HARSH070105/tml_work/Intern Report - Harsh Kapoor.pdf

Internship Project Report

## Automated A.C. Vent Controlling System

Submitted by

Harsh Kapoor
Electronics and Communication Engineering International Institute of Information Technology - Hyderabad

Under the guidance of

Kartar Singh
Deputy General Manager
Tata Motors, Engineering Research Centre

Varnit Vats
General Manager
Tata Motors, Engineering Research Centre

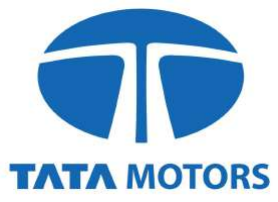
[picture p1: figure]

## TATA MOTORS

Engineering Research Centre

Summer Internship 2025

# Contents

1 Objective | 1
2 Introduction | 2
3 Work Done | 10
4 Future Work | 28
Acknowledgment | 29
References | 30

i

# Chapter 1

# Objective

The primary objective of this project was to automate the operation of air-conditioning (A.C.) vents in electric commercial vehicles, thereby enhancing energy efficiency and passenger comfort. The task involved designing a smart control system that could dynamically manage the A.C. vents based on passenger presence. To achieve this, the following goals were set:

- Passenger Detection Pipeline: Develop a reliable pipeline to detect and localize passengers in the vehicle cabin using appropriate sensing and vision-based techniques.
- Vent Control Mechanism: Design and implement a mechanism capable of actuating A.C. vents—opening or closing them—based on control commands.
- System Integration: Seamlessly integrate the passenger detection system with the A.C. vent control mechanism to allow real-time, responsive operation.
- Proof of Concept (PoC): Build a functional proof of concept simulating various components of an electric commercial vehicle to demonstrate the end-to-end working of the proposed solution.

# Chapter 2

# Introduction

## 2.1 Vehicle Studies

As part of the internship, I was tasked to study the various electronic sensors and control units used in commercial vehicles. This involved gaining a detailed understanding of the components that contribute to vehicle automation, safety, and control. The Vehicles I studied are -

### 2.1.1 CNG - 1620 Buro - 6

This was a CNG vehicle equipped with six CNG tanks. The vehicle had dimensions of a × b where a is the floor height in 100s of mm and b is the bus length from front to back.
The following image is a diagrammatic representation of the vehicle layout. It indicates the placement of the various sensors and electronic controllers throughout the vehicle.

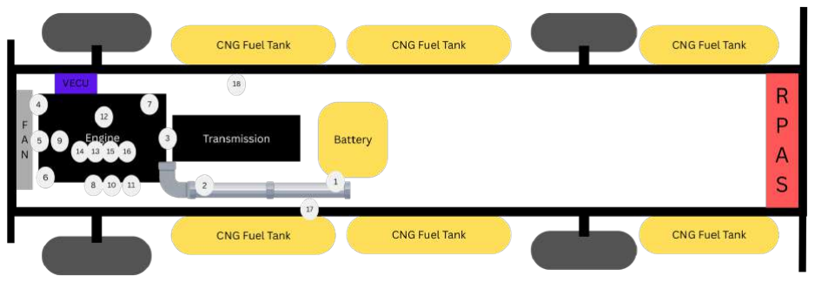
[picture p2: figure]

Figure 2.1: Diagrammatic Representation of 1620 CNG Vehicle

The Description of the components (along with the names of the numbered components in the image) are as follows -

S.No | Sensor Name | Sensor Purpose
1 | G.P.F. | GPF (Gasoline Particulate Filter) sensor is a compo-nent of the exhaust system in gasoline engines designed to capture particulate matter. It works by measuring pressure differences across the GPF, which indicates the amount of soot buildup within the filter. This informa-tion is then used by the engine control unit (ECU) to trigger regeneration cycles, which burn off the trapped soot and maintain optimal filter performance
2 | Post Oxygen Sensor | Detects the concentration of oxygen molecules in the ex-haust air, this combined with the Pre Oxygen measure-ment tells the ECU the amount of Oxygen being used in engine for fuel combustion, and whether it needs more air to be sucked in or not.
3 | Crank Sensor | Monitors the position or rotational speed of the crankshaft (converts linear motion of pistons to rota-tional motion of wheels)
4 | E Viscous Fan | Utilizes electronic control to optimize fan speed and op-eration for cooling engine. It is controlled by the ECU, and this is based on Engine oil temperature and the coolant temperature. Its speed can be varied instead of being in a binary state (on/off based on bimetallic strip).
5 | CAM | Monitors the camshaft (which controls the timing of in-let and exhaust valve operations) position and speed and feeds that data to the vehicle’s ECU. The ECU needs this data to control how much fuel enters the combus-tion chamber and ignition (spark) timing to ignite the fuel.
6 | ETB | (Electric Throttle Body) Controls how much air the ve-hicle’s engine receives based on how far the gas pedal is pressed. Controlled by the ECU based on the gas pedal, and the oxygen sensors data.
7 | Oil Pressure and Tem-perature Sensor | Measures the pressure and temperature of the engine oil. This data is fed to the ECU and controls the Fans speed and the amount of coolant intake.
8 | Pre Oxygen Sensor | Detects the concentration of oxygen molecules in the intake air and the data is passed on the ECU for the usage in ETB control.
9 | Coolant Temperature Sensor | To sense the temperature of the coolant of the engine.
10 | Pre Throttle TMAP Sensor | Measures the temperature and pressure of the air before it enters the throttle body (controls air intake) of an engine. Throttle is the valve from which air enters the engine; therefore, the sensor measures the temperature and pressure of the air entering the engine so that the control of intake air can be done.

11 | Exhaust Temperature Sensor | To sense the temperature of the exhaust gas of the en-gine. This helps in optimizing engine performance by changing fuel oxygen fix in engine.
12 | Ignition Coils | Transform the low voltage from the battery (here 24V) into a much higher voltage (tens of thousands of volts) needed to create a spark at the spark plug, igniting the fuel-air mixture in the engine.
13 | Fuel Injectors | Device for atomizing and injecting fuel into an internal combustion engine
14 | TMAP Sensor | Measures the pressure and temperature of the air in an engine. This helps in the efficiency of engine by control-ling the combustion by fuel and air by ecu.
15 | Fuel Rail Tempera-ture Sensor | Monitors the temperature inside the fuel rail (a metal tube that connects the fuel delivery system to the en-gine)
16 | Gas Rail Pressure Sensor | Monitors the pressure inside the gas (CNG) rail (a metal tube that connects the fuel delivery system to the en-gine)
17 | VECU | Manages and controls various electronic systems using the data from the sensors of the vehicle.
18 | HP Cutoff Solenoid Assembly | Used to shut off the flow of High-pressure Fuel at the fuel inlet.
19 | RPAS Sensor | Reverse Parking Assistance Systems are automated parking systems that help drivers park with extreme ease and precision.
20 | NOX Sensor | Measures the amount of Nitrogen Oxides in the exhaust fumes.

### 2.1.2 Electric Vehicle - Magna

This was an electric vehicle equipped with four 700kg, 665.6V, 150Ah, 99.84kWh battery packs which are connected in parallel.
The following image is a diagrammatic representation of the vehicle layout. It indicates the placement of the various sensors and electronic controllers throughout the vehicle.

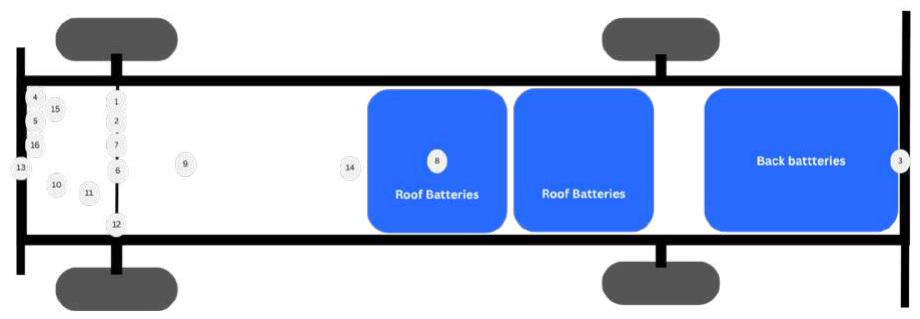
[picture p3: figure]

Figure 2.2: Diagrammatic Representation of Magna Vehicle

The Description of the components (along with the names of the numbered components in the image) are as follows -

S.No. | Sensor Name | Sensor Purpose
1 | G.D.C.U. | Gateway Domain Control Unit, acts as a hub for data exchange, and connects various parts of the vehicle via signals
2 | VECU | Vehicle Electronic Control Unit, used for low voltage controls
3 | RPAS | Assists the driver in reversing and parking by using range detection to scan the surroundings. 5 in number – 1 master and 4 slave sensors, all at the back
4 | Data Logger | Logs the data of various sensors with time stamps for troubleshooting and sequencing of commands
5 | TCU Telematics | Provides telematics data (GPS, IMU, etc.) of the vehicle
6 | E.B.S. | Electronic Braking System; helps achieve shorter brak-ing distances using electronic control signals
7 | EVCU | Electric Vehicle Control Unit, used in high voltage con-trols
8 | BMS | Battery Monitoring System; manages the health and status of the battery pack
9 | MCU | Motor Control Unit; controls speed and gear ratio of the motors
10 | DC-DC Converter | Converts DC high voltage to DC low voltage, or vice versa
11 | AUX | Converts DC to AC for powering systems like power steering (AUX 1) and the AC unit (AUX 2)
12 | TCP | Traction Cooling Pump; used to control motor traction temperature
13 | HVAC | AC Control Unit; controls the blower and compressor settings
14 | BCS | Battery Control System; controls the charge/discharge rate of the battery, optimizing performance
15 | Steering Angle | Detects the angle to which the steering wheel is turned
16 | DMS | Driver Monitoring System; monitors the driver’s state and helps keep them alert

## 2.2 A.C. Vent Fitment

I also visited the Tata Motors Body Solutions Limited (TMBSL) plant to inspect the A.C. vent fitment in the vehicle. The objective of the visit was to understand the feasibility of designing a mechanism that could automate the opening and closing of the A.C. vents using actuators. Images of the vents in their open and closed positions are shown below:

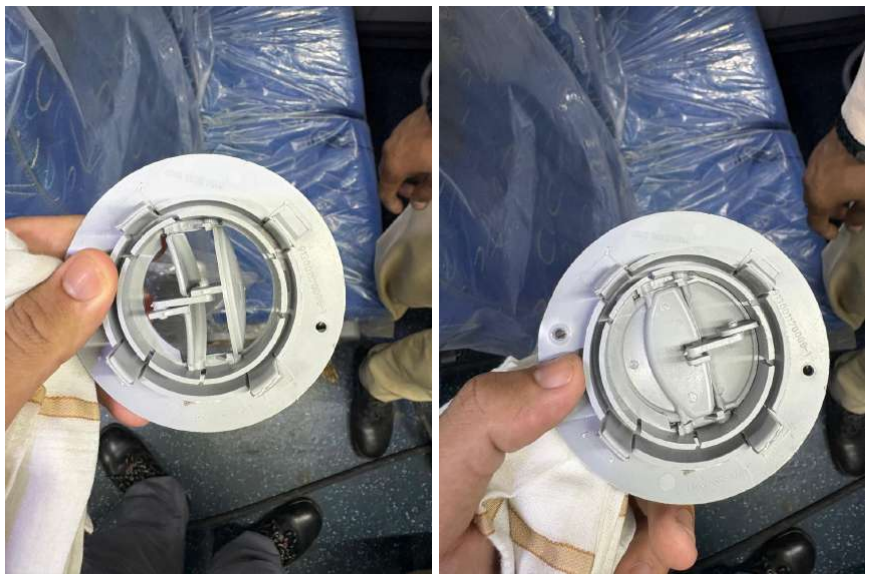
[picture p4: figure]

Figure 2.3: Vent in Open and Closed Position

I also Calculated the area and the number of AC Vents as a part of the project so that the Compressor and Blower in the vehicle can be adjusted based on the number of closed/open vents so that energy can be saved. The Detailed Calculations are given in the following sections.

## 2.3 Passenger Detection Techniques

To enable automatic opening and closing of the A.C. vents based on passenger presence, I proposed the following methods of passenger detection, with their respective advantages and limitations-

### 2.3.1 Pressure Sensor

The idea is to have pressure sensors in seat to detect the weight of a person on the seats. It is similar to the seatbelt warnings in passenger vehicles. A certain threshold of weight will be required for the vents to respond to.

Advantages:

- The main advantage is that it is very easy to interface, as one sensor controls one vent.
- It is already used in Passenger Vehicles so the complexity of ideation is excluded.

Disadvantages:

- Will be needing at-least one per seat, the wiring will increase.
- This method not be able to distinguish between Humans and other objects kept on seat.

### 2.3.2 Infra-Red/Temperature Sensor

The idea is to have I.R. Sensors pointing at seats to detect human body temperatures. This method will turn on the AC Vents if the human body temperature is detected and will turn it off if it is not detected for a prolonged period of time.

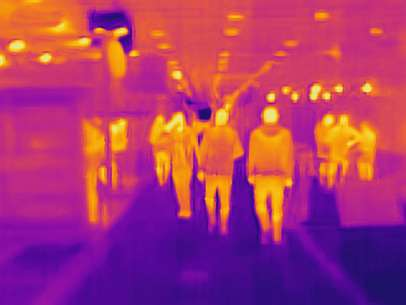
[picture p5: figure]

Figure 2.4: Images from an IR Camera Distinguishing Human Temperatures

Advantages:

- The main advantage is that it is very easy to interface, as one sensor controls one vent.
- It is better suited for human detection than pressure sensor as it relies on body temperature.

Disadvantages:

- Will be needing at-least one per seat, the wiring will increase.
- This method not very reliable for Indian subcontinent, as the ambient temperature is already high.

### 2.3.3 Ultrasonic/Range Sensor

This method utilizes the difference of distances between two seats in the presence or absence of person. We place an ultrasonic sensor at the back of the seat in front and then measure the distance. In the presence of a human the distance is bound to decrease.

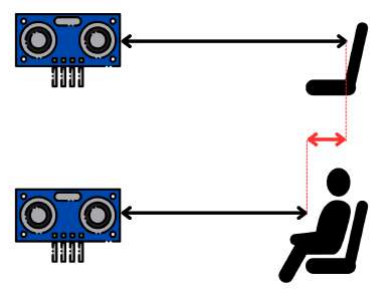
[picture p6: figure]

Figure 2.5: Ultrasonic Sensor Working, Red line depicts the difference in measurements

Advantages:

- The main advantage is that it is very easy to interface, as one sensor controls one vent.
- It is already used in automatic light and fans in rooms.

Disadvantages:

- Will be needing at-least one per seat, the wiring will increase.
- This method not be able to distinguish between Humans and other objects kept on seat.

### 2.3.4 Capacitive Detection

The idea is to setup Electric fields in the vicinity of the seats and detect interference in the fields as humans have a characteristic capacitance which can be detected accurately.

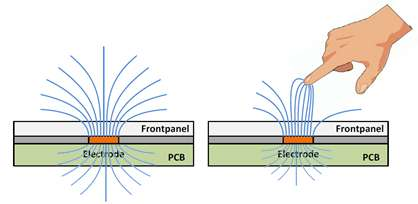
[picture p7: figure]

Figure 2.6: Working of Capacitive Detection

Advantages:

- Can accurately detect human presence despite motion, clothing, position, etc.
- It is already used in safety equipments like chainsaws, blades etc.

Disadvantages:

- Is not used at this scale and application before, therefore field strength required is not known and hard to calculate.
- The field may interfere with workings of other components and to be isolated and contained.

### 2.3.5 Computer Vision and Machine Learning

This track requires to have cameras placed in the bus and to detect humans using pretrained algorithms running on a micro processor. It utilizes already present camera to track humans on the seats using bounding boxes.

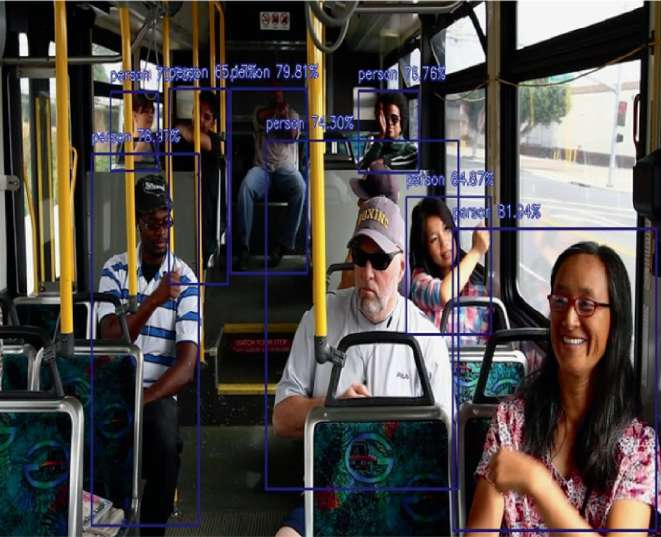
[picture p8: figure]

Figure 2.7: Passenger Detection using Computer Vision

Advantages:

- The main advantage is that it needs a few cameras to cover the entire vehicle.
- It can be used for counting passengers in vehicle and enhancing security in vehicles.

Disadvantages:

- Need large compute power even if we use pre-trained models for detection.
- This method is not very suitable if seats are high (have head support) as it will block the view of the passengers behind.

After evaluating all possible sensing methods, the final choice was to adopt a Computer Vision based approach. This method offers the advantage of requiring only a single sensing element a camera while still being capable of reliably detecting human presence. Its flexibility, ease of integration with modern embedded systems, and potential for future scalability made it the most practical and robust solution for vent automation.

# Chapter 3

# Work Done

## 3.1 Vent Opening Mechanism

Automating the A.C. vents involves the design and integration of both mechanical and electronic components. The following key tasks are necessary to realize the following systems -

### 3.1.1 Actuator Selection

The selection of a suitable actuator depends primarily on three factors: power consumption, ease of availability, and ease of integration on production lines.

- Servo Motors: These actuators are energy-efficient and readily available in the market. However, they require precise alignment and mounting, which may pose challenges in large-scale production environments where repeatability and minimal manual intervention are crucial.
- Solenoid Valves: Although they consume relatively more power, solenoid valves are easier to fit into existing production setups due to their simpler actuation mechanism and mounting requirements. Their widespread industrial use also makes them easy to source.

### 3.1.2 C.A.D. of Mechanism

Designing the vent opening mechanism required careful planning to ensure that the actuator could move the vent flaps reliably. For this, a 3-D model of the mechanism was developed using C.A.D. software (Autodesk’s Fusion-360). The CAD model helped us:

- Visualize and simulate the motion of the flaps to confirm they could fully open and close.
- Check if the mechanism fits well with the existing vent design, without the need for major modifications.
- Find the best position for the actuator so that it’s easy to install and maintain.

Following are the images of the 3-D model and the sectional diagrams of the prototype made.

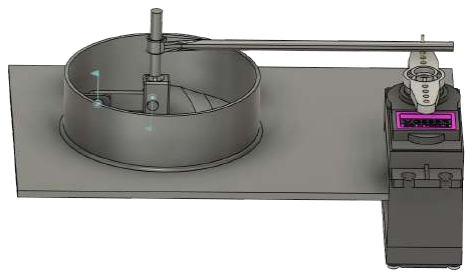
[picture p9: figure]

Figure 3.1: Vent Design with additional control

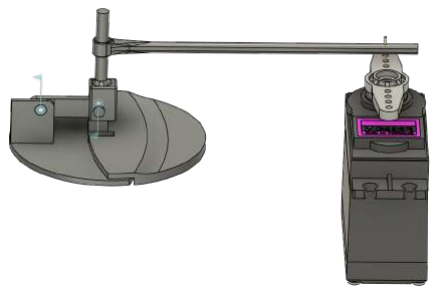
[picture p10: figure]

Figure 3.2: Control Mechanism, Vent State: Closed

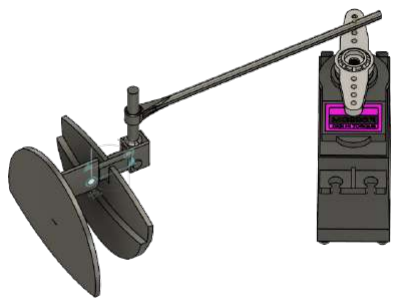
[picture p11: figure]

Figure 3.3: Control Mechanism, Vent State: Open

## 3.2 Automation Algorithm Design

To control the vent opening and closing automatically, a simple yet effective algorithm is designed. The logic is based on inputs, such as passenger presence, and user preferences. These inputs are processed to determine the optimal vent status. The decision-making process is illustrated in the flow diagram below.

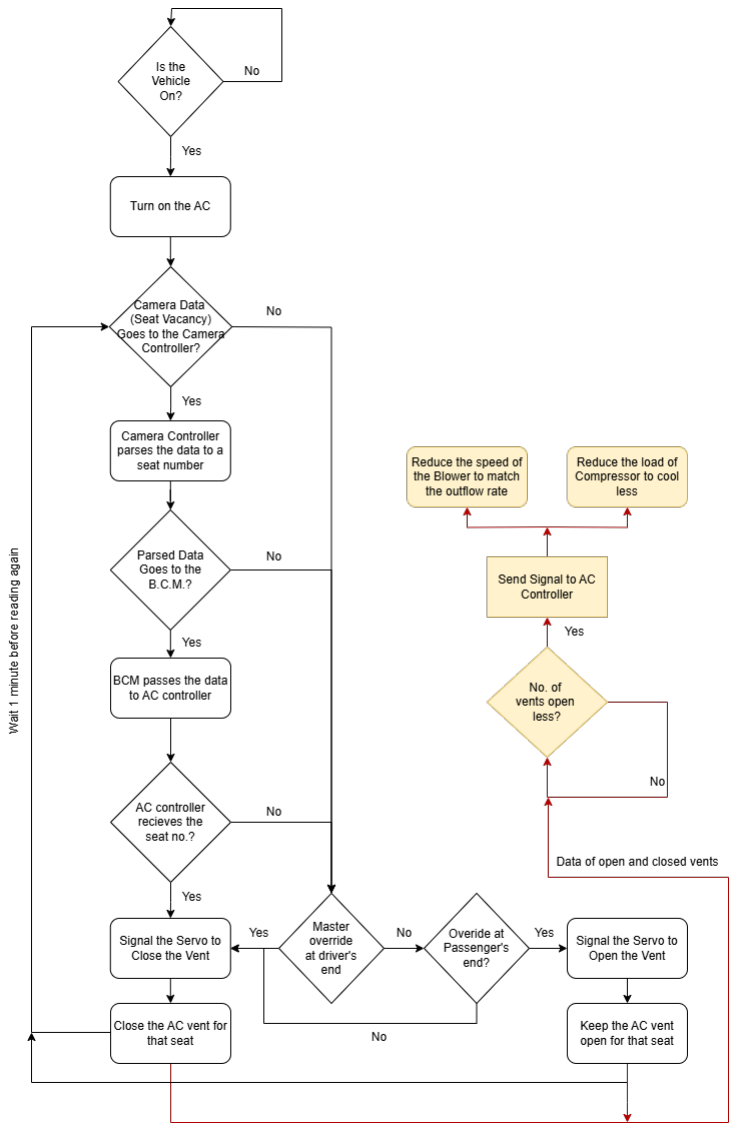
[picture p12: figure]

Figure 3.4: Flow diagram representing the logic for Vent Automation

The automation algorithm begins by checking whether the vehicle is powered on. Once the vehicle is on, the system proceeds to activate the air conditioning. The next step involves detecting passenger presence.
The core logic of the algorithm is built around the assumption that vents should remain open by default. This approach prioritizes passenger comfort by placing constraints only on vent closure. In the event of a malfunction in any subsystem, the default open state ensures that airflow is not interrupted.
Passenger detection is carried out using a camera-based system, which processes visual data to determine seat occupancy. Based on this information, the system identifies which vents need to be closed. This seat-specific data is then transmitted to the A.C. Controller via the Body Control Module (BCM).
Importantly, if the data transmission fails at any stage, the vents remain open by design. This prevents erroneous closures, such as a vent shutting off when a passenger is actually present.
Once the A.C. Controller receives the occupancy data, it toggles the vents accordingly. A master control is available to the driver, allowing them to override the system and open or close all vents simultaneously, a useful feature for cooling shuttle buses preemptively before passengers board. Additionally, passengers are given manual control to close their individual vents or open them if they remain closed unintentionally.
Moreover, the data regarding the number of open and closed vents can be fed back to the A.C. Controller. This enables dynamic adjustment of blower speed and compressor settings, leading to optimized energy consumption and improved system efficiency.
The algorithm currently runs at a rate of 1 frame per minute. This is done to minimize the computing power required to run the pretrained model on an edge computing device, like the Camera Controller. This also makes sure that the vents remain open even if passenger moves for a while.

## 3.3 A.C. & Blower Control

The A.C. vents are designed to operate optimally at an airflow rate between 5 to 7.5 m/s. However, when multiple vents are closed — either due to unoccupied seats or manual passenger inputs — the airflow dynamics change. This can result in increased flow velocity through the remaining open vents, potentially compromising passenger comfort. To address this, the blower speed must be dynamically adjusted based on the number of open vents. By reducing the blower speed when fewer vents are open, we can maintain consistent airflow across all active vents, ensuring comfort and reducing unnecessary energy consumption. Following table contains the information of all the vents present in a vehicle.

Vent Type | Vent Length (mm) | Vent Breadth (mm) | Vent Area (cm² )
Circular (controllable vent) | 45 | 45 | 15.89625
Rectangular (small and always open) | 92 | 5 | 4.6
Rectangular (bigger and always open) | 130 | 40 | 52

From this, using fluid dynamics we can calculate what is the total outflow rate of the vents and the total inflow rate from the blowers. Using this data we can control the blowers’ speed and also save on power.

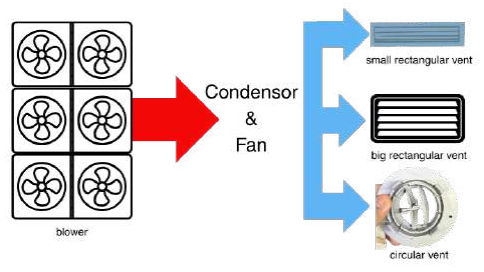
[picture p13: figure]

Figure 3.5: Air Flow diagram of AC

The total volumetric flow rate from all the vents, assuming there are nc circular vents, nrs small rectangular vents and nrb big rectangular vents with the flow rate being 7.5m/s is -
(15.9nc + 4.6nrs + 53nrb)

7.5
10⁴ m³
/s

If there are nb blowers and each blower has an area of Ab m² with flow rate of fb m/s, the total volumetric flow rate from blowers is -

nbAbfb m³
/s

At all vents open, the total flow rate out from vents should equal the total flow rate in from the blowers as no air remains in the ducts. This means -

(15.9nc + 4.6nrs + 53nrb)

7.5
10⁴

= nbAbfb

If we assume ncclosed number of controllable vents are closed, the number of blowers required are n

′
b

, then -

(15.9(nc − ncclosed ) + 4.6nrs + 53nrb)

7.5
10⁴

= n

′
bAbfb

(15.9nc + 4.6nrs + 53nrb)

7.5
10⁴

− ncclosed

15.9 × 7.5
10⁴

= n

′
bAbfb

nbAbfb − ncclosed

15.9 × 7.5
10⁴

= n

′
bAbfb

nb − ncclosed

15.9 × 7.5
10⁴Abfb

= n

′
b

Therefore, the number of Blowers that can be closed =
ncclosed

1.2
100Abfb
, where ⌊x⌋

means the floor value of x. In case we want to consider the difference of densities of the hot air being flowed in and the cold air being flowed out, we can use -
ncclosed

1.2ρcold

100Abfbρhot

## 3.4 A.C. Vent Automation Pipeline

### 3.4.1 Component Selection

The P.O.C. required the simulations of the various components which are present in the vehicle. For cost savings and ease of use the following components were selected along with rationale and requirements -

S.no. Component | | Requirements | Selected De-vice | Rationale
1. Camera | | Image to be clear, and use CSI proto-col | Raspberry Pi Camera | Checked the re-quirements and is of Raspberry Pi, ease in interfacing
2. | Camera Con-troller | Can run light weight human de-tection algorithms, Can forward a seat number ahead | Raspberry Pi Zero 2 W | Good compute power, basically a computer in a package
3. | Body Control Module | To take input a digi-tal bitstream and to forward it to the AC Controller | ESP32 WROOM-32 | Easy to work with, can take in data well
4. A.C. Controller | | Have multiple GPIO pins to toggle the various Vents. To be able to receive a bitstream and send signal to the actuator | ESP32 WROOM-32 | Easy to work with, can take in data well, and multiple output pins with good enough com-pute to calculate the change in Fan speed etc
5. 5V Buck Con- | verter | Needed to change voltage from 24V of bus to 5 needed for the Controller | LMR51420 -5V | Cheap
6. 3.3V Buck Con- | verter | Needed to change voltage from 24V of bus to 3.3V needed for the Controller | LMR51420 -3.3V | Cheap
7. Actuators | | Not consume much power. Have enough length when toggled to the ex-tended position. | MG-996R Servo Motor | Cheap, Available in offline stores

### 3.4.2 Pipeline Overview

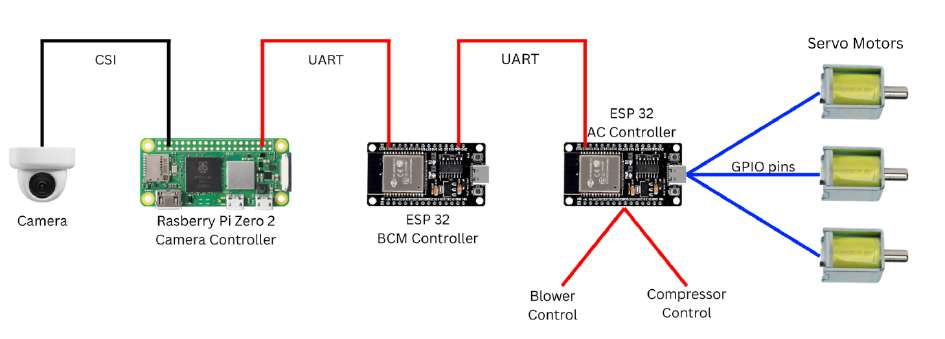
[picture p14: figure]

Figure 3.6: Pipeline Overview

The above image shows the pipeline with the electronics modules as the components in the vehicle. The first leg of the pipeline has the camera and the camera controller. The camera takes a picture at regular intervals and sends it to the camera controller via a CSI (Camera Serial Interface) port on the Raspberry Pi. The Raspberry Pi runs the human detection algorithm and determines the seat numbers of the vacant and occupied seats. This seat occupancy data is then passed to the Body Control Module (BCM), which in our implementation is an ESP-32 microcontroller. The communication between the Raspberry Pi and the BCM is handled via a UART (Universal Asynchronous Receiver/-Transmitter) protocol. UART was chosen for its simplicity and ease of implementation in prototyping stages. However, the system is modular and can later be upgraded to CAN (Controller Area Network) for better noise immunity and scalability.
The final stage of the pipeline is the AC Controller module. Communication between the BCM and the AC Controller can be done via UART protocols. For ESP32-to-ESP32 communication, it was chosen due to its superior efficiency in multi-device setups. Based on the received data, the corresponding actuator is activated to open the respective AC vent. Additionally, the AC Controller manages the Blower and Compressor units by dynamically adjusting their states depending on environmental and occupancy conditions. It also has the 30 second timer which closes the vent.

## 3.5 Hardware Design and Integration

I used the Arduino IDE for programming the ESP32 modules. The download link for the IDE is provided in the References section. To upload code to the ESP32, connect it to your laptop or computer using a micro-USB cable.
In the Arduino IDE, first install the ESP32 Board Package by Espressif Systems (or the Arduino AVR Boards package, which is for AVR-based boards like the Arduino Uno). You can do this via Tools => Board => Boards Manager, then search for ESP32 and install it.
Once the package is installed, go to Tools => Board and select ESP32 Dev Module. Also, ensure that the correct COM port is selected (usually COM3, COM4, or COM5 depending on your system).

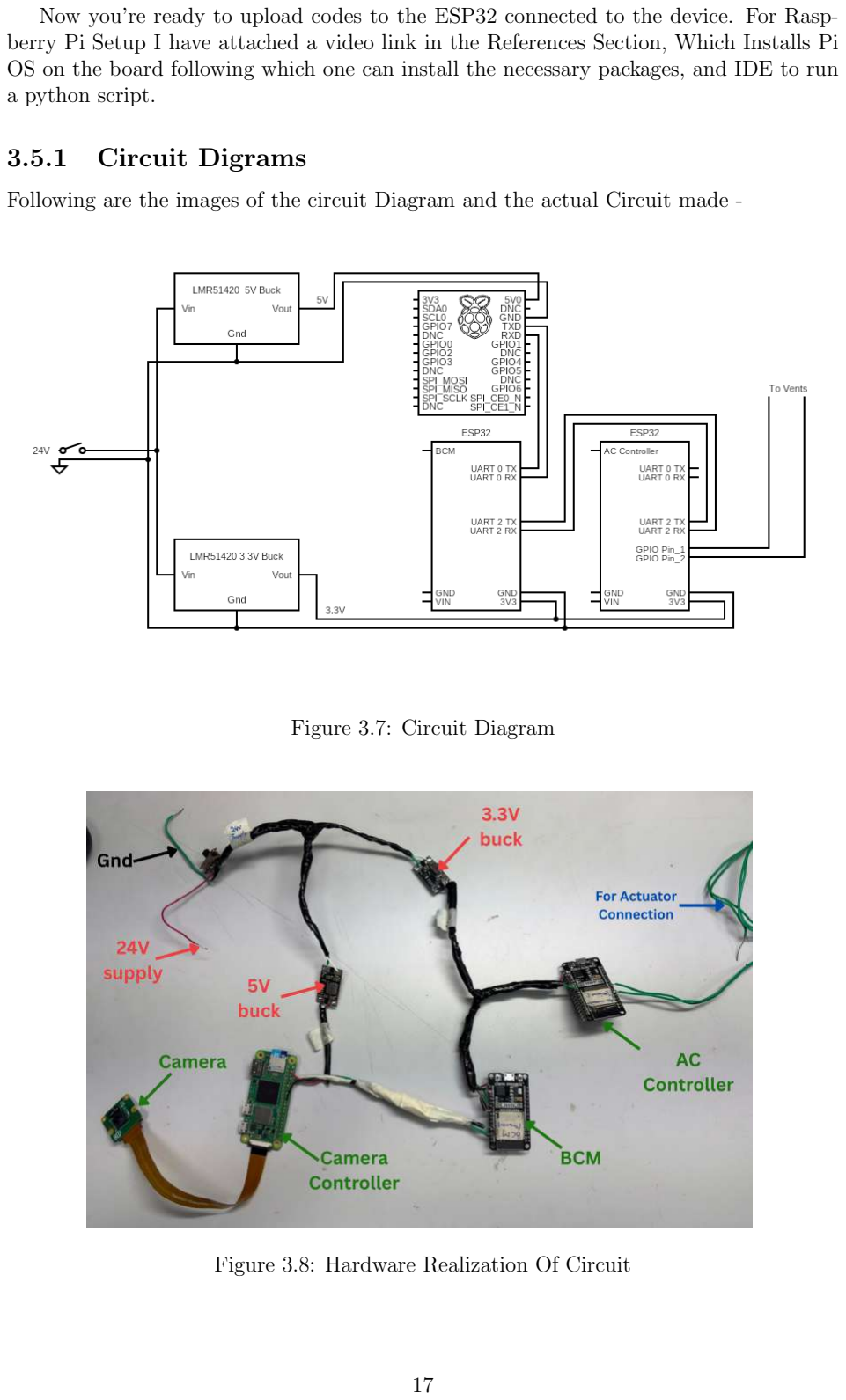
[picture p15: page 19]

Now you’re ready to upload codes to the ESP32 connected to the device. For Raspberry Pi Setup I have attached a video link in the References Section, Which Installs Pi OS on the board following which one can install the necessary packages, and IDE to run a python script.

### 3.5.1 Circuit Digrams

Following are the images of the circuit Diagram and the actual Circuit made -

Figure 3.7: Circuit Diagram

Figure 3.8: Hardware Realization Of Circuit

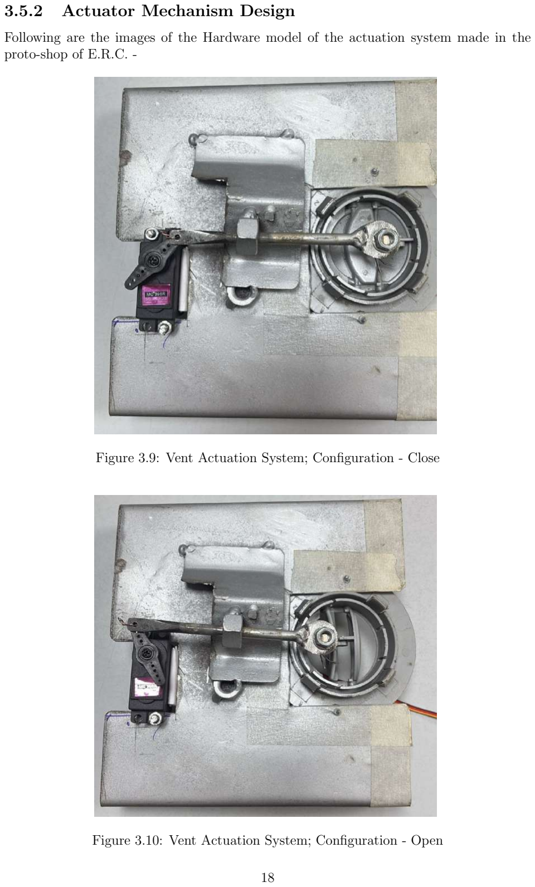
[picture p16: page 20]

### 3.5.2 Actuator Mechanism Design

Following are the images of the Hardware model of the actuation system made in the proto-shop of E.R.C. -

Figure 3.9: Vent Actuation System; Configuration - Close

Figure 3.10: Vent Actuation System; Configuration - Open

### 3.5.3 Controller Codes

Following are the codes written for the various modules. The Descriptions and languages are mentioned below, and a GitHub link to the repository with all the documentation.

Camera Controller

The Code was written in Python and later ported to PI OS for Pi Zero 2 W. This code lets us draw the Areas of Interest (AOIs), and then detects humans in those Boxes.

1 | import cv2
2 | import numpy as np
3 | import serial
4 | import time

5
6 | rois = []
7 | drawing = False
8 | ref_point = []

9
10 | # --- Detection Parameters ---
11 | DETECTION_PARAMS = {
12 | " winStride ": (5 , 4) ,
13 | " padding ": (16 , 16) ,
14 | " scale ": 1.05 ,
15 | " hitThreshold ": -0.35 ,
16 | }

17
18 | # --- Mouse Callback Function ---
19 | def draw_roi ( event , x , y , flags , param ) :
20 | global ref_point , drawing , rois , frame

21
22 | if event == cv2 . EVENT_LBUTTONDOWN :
23 | ref_point = [( x , y ) ]
24 | drawing = True

25
26 | elif event == cv2 . EVENT_MOUSEMOVE and drawing :
27 | frame_copy = frame . copy ()
28 | cv2 . rectangle ( frame_copy , ref_point [0] , (x , y ) , (0 , 255 , 0) , 2)
29 | cv2 . imshow (" Human Detector - ROI Selection ", frame_copy )

30
31 | elif event == cv2 . EVENT_LBUTTONUP :
32 | ref_point . append (( x , y ) )
33 | drawing = False
34 | x1 , y1 = ref_point [0]
35 | x2 , y2 = ref_point [1]
36 | rois . append (( min ( x1 , x2 ) , min ( y1 , y2 ) , max ( x1 , x2 ) , max ( y1 , y2 ) )
| )
37 | print ( f"ROI added : { rois [ -1]}")

38
39 | # --- Main Function ---
40 | def main () :
41 | global frame

42
43 | # --- Serial Port Setup ---
44 | try :
45 | # Adjust ’COM3 ’ to your specific port if necessary it can be
| viewed in the Arduino IDE or Device Manager .
46 | # For Windows , it might be something like ’COM3 ’ or ’COM4 ’
47 | # For Linux , it might be something like ’/dev/ ttyUSB0 ’
48 | # For macOS , it might be something like ’/dev/cu. usbmodemXXXX ’

49 | ser = serial . Serial (’COM3 ’, 115200 , timeout =1)
50 | time . sleep (2) | # Allow time for Arduino or device to initialize
51 | print (" Serial connection established on COM Port ")
52 | except Exception as e :
53 | print ( f" Warning : Could not open serial port . {e}")
54 | ser = None

55
56 | # --- HOG Detector Setup ---
57 | hog = cv2 . HOGDescriptor ()
58 | hog . setSVMDetector ( cv2 . HOGDescriptor_getDefaultPeopleDetector () )

59
60 | # --- Video Capture Setup ---
61 | cap = cv2 . VideoCapture (0)
62 | if not cap . isOpened () :
63 | print (" Error : Could not open camera .")
64 | return

65

66
67 | window_name = " Human Detector - ROI Selection "
68 | cv2 . namedWindow ( window_name )
69 | cv2 . setMouseCallback ( window_name , draw_roi )

70
71 | detection_mode = False

72
73 | # --- Instructions ---
74 | print (" Welcome to the Human Box Detector !")
75 | print (" --- ROI Selection Mode ---")
76 | print (" Press ’d’ to start drawing a new box.")
77 | print (" Press ’c’ to clear all boxes .")
78 | print (" Press ’s’ to save ROIs and start detection .")
79 | print (" Press ’q’ to quit .")

80
81 | while True :
82 | ret , frame = cap . read ()
83 | if not ret :
84 | print (" Error : Failed to capture frame .")
85 | break

86
87 | frame = cv2 . flip ( frame , 1)
88 | key = cv2 . waitKey (1) & 0 xFF

89
90 | if key == ord (’q’) :
91 | break
92 | elif key == ord(’s’) and not detection_mode :
93 | if not rois :
94 | print (" Warning : No ROIs defined . Press ’d’ to draw at
| least one.")
95 | else :
96 | detection_mode = True
97 | print ("\n- - - Detection Mode Started ---")
98 | cv2 . destroyWindow ( window_name )
99 | window_name = " Human Detector - Running "
100 | cv2 . namedWindow ( window_name )
101 | elif key == ord(’c’) :
102 | rois . clear ()
103 | print ("All ROIs cleared .")
104 | elif key == ord(’d’) :
105 | print (" Ready to draw . Click and drag your mouse on the
| window .")

107 | if not detection_mode :
108 | display_frame = frame . copy ()
109 | cv2 . putText ( display_frame , " Mode : ROI Selection ", (10 , 30) ,
| cv2 . FONT_HERSHEY_SIMPLEX , 0.7 , (0 , 0 , 255) , 2)
110 | cv2 . putText ( display_frame , "d: Draw | c: Clear | s: Start |
| q: Quit ", (10 , 60) , cv2 . FONT_HERSHEY_SIMPLEX , 0.7 , (0 , 0 , 255) , 2)
111 | for ( x1 , y1 , x2 , y2 ) in rois :
112 | cv2 . rectangle ( display_frame , ( x1 , y1 ) , ( x2 , y2 ) , (0 ,
| 255 , 0) , 2)
113 | cv2 . imshow ( window_name , display_frame )

114
115 | else :
116 | display_frame = frame . copy ()
117 | cv2 . putText ( display_frame , " Mode : Detection | q: Quit ", (10 ,
30) , cv2 . FONT_HERSHEY_SIMPLEX , 0.7 , (0 , 0 , 255) , 2)
118 | status_report = []

119
120 | for i , ( x1 , y1 , x2 , y2 ) in enumerate ( rois ) :
121 | roi_frame = frame [ y1 : y2 , x1 : x2 ]
122 | if roi_frame . size == 0:
123 | continue

124
125 | detections , _ = hog . detectMultiScale ( roi_frame , **
| DETECTION_PARAMS )
126 | roi_has_human = len( detections ) > 0
127 | roi_color = (0 , 255 , 0) if roi_has_human else (0 , 0 ,
| 255)

128
129 | status_report . append ( f"ROI #{i +1}: { ’ DETECTED ’ if
| roi_has_human else ’Clear ’}")

130
131 | cv2 . rectangle ( display_frame , ( x1 , y1 ) , ( x2 , y2 ) ,
| roi_color , 2)
132 | cv2 . putText ( display_frame , f"ROI {i+1}", ( x1 , y1 - 10) ,
| cv2 . FONT_HERSHEY_SIMPLEX , 0.6 , roi_color , 2)

133
134 | for (x , y , w , h ) in detections :
135 | abs_x , abs_y = x + x1 , y + y1
136 | cv2 . rectangle ( display_frame , ( abs_x , abs_y ) , ( abs_x
| + w , abs_y + h ) , (255 , 0 , 0) , 2)

137
138 | # --- Serial Output on Detection ---
139 | if roi_has_human and ser :
140 | message = f" DETECTED in Frame {i +1}\ n"
141 | ser . write ( message . encode (’utf -8 ’) )

142
143 | print (’ | ’. join ( status_report ) , end =’\r’)
144 | cv2 . imshow ( window_name , display_frame )

145
146 | # --- Cleanup ---
147 | cap . release ()
148 | if ser :
149 | ser . close ()
150 | print ("\ nSerial connection closed .")
151 | cv2 . destroyAllWindows ()
152 | print ("\ nApplication closed .")

153
154 | # --- Main Entry Point ---
155 | if __name__ == ’__main__ ’:
156 | main ()

Body Control Module

The Code was written in Arduino’s Language which very closely resemble with C.

1 # include < Arduino .h >

2
3 | // UART2 Pins for forwarding data
4 | # define UART2_TX 17
5 | # define UART2_RX 16

6
7 | // Status LED ( optional )
8 | # define STATUS_LED 2

9
10 | // Communication parameters
11 | const int USB_BAUD = 115200; | // USB Serial baud rate ( matches Python )
12 | const int UART2_BAUD = 9600; | // UART2 baud rate ( matches receiver
| ESP32 )

13
14 | // Timing and status variables
15 | unsigned long lastDataTime = 0;
16 | unsigned long ledBlinkTime = 0;
17 | bool ledState = false ;
18 | bool debugMode = true ;
19 | int messageCount = 0;

20
21 | void setup () {
22 | // Initialize USB Serial ( Serial0 ) - for receiving from Python
23 | Serial . begin ( USB_BAUD ) ;
24 | delay (1000) ; // Give serial time to initialize

25
26 | Serial2 . begin ( UART2_BAUD , SERIAL_8N1 , UART2_RX , UART2_TX ) ;
27 | Serial . println (" UART2 initialized on pins TX :17 , RX :16 ") ;

28
29 | // Initialize status LED
30 | pinMode ( STATUS_LED , OUTPUT ) ;
31 | digitalWrite ( STATUS_LED , LOW ) ;
32 | }

33
34 | void loop () {
35 | // Check for data from USB Serial ( Python code )
36 | if ( Serial . available () ) {
37 | String receivedData = Serial . readStringUntil (’\n’) ;
38 | receivedData . trim () ;

39
40 | if ( receivedData . length () > 0) {
41 | lastDataTime = millis () ;
42 | messageCount ++;

43
44 | // Process and forward the message
45 | String forwardMessage = processMessage ( receivedData ) ;

46
47 | if ( forwardMessage . length () > 0) {
48 | Serial2 . println ( forwardMessage ) ;
49 | }
50 | }
51 | }

52
53 | delay (10) ; // Small delay to prevent excessive CPU usage
54 | }

55
56 // Process incoming message and format for UART2

57 | String processMessage ( String input ) {
58 | String output = "";

59
60 | // Look for detection messages from Python
61 | if ( input . indexOf (" DETECTED in Frame ") != -1) {
62 | // Extract frame number
63 | int frameStart = input . indexOf (" Frame ") + 6;
64 | int frameEnd = input . indexOf (" ", frameStart ) ;
65 | if ( frameEnd == -1) frameEnd = input . length () ;

66
67 | String frameNumber = input . substring ( frameStart , frameEnd ) ;
68 | frameNumber . trim () ;

69
70 | // Format message for receiver ESP32
71 | output = " Frame " + frameNumber ;

72
73 | Serial . print ("[ PROCESS ] Detection in Frame ") ;
74 | Serial . print ( frameNumber ) ;
75 | Serial . println (" - Forwarding to receiver ") ;

76
77 | } else if ( input . indexOf (" Frame ") != -1) {
78 | // Direct frame message - forward as is
79 | output = input ;
80 | Serial . println ("[ PROCESS ] Direct frame message - Forwarding ") ;

81
82 | } else {
83 | // Unknown message format
84 | if ( debugMode ) {
85 | Serial . print ("[ PROCESS ] Unknown format : ") ;
86 | Serial . println ( input ) ;
87 | }
88 | }

89
90 | return output ;
91 | }

A.C. Controller

The Code was written in Arduino’s Language which very closely resemble with C.

1 # include < Arduino .h >

2
3 | // UART Pins
4 | # define UART_TX 17
5 | # define UART_RX 16

6
7 | // Servo PWM GPIOs
8 | # define VENT1_SERVO_PIN 32 | // Control for Frame 1
9 | # define VENT2_SERVO_PIN 25 | // Control for Frame 2

10
11 | // Servo parameters for MG996R
12 | const int pwmFreq = 50; | // 50 Hz
13 | const int pwmResolution = 16; | // 16 - bit resolution
14 | const int maxDuty = 65535; | // 2^16 - 1

15
16 | // Servo angles
17 | const int VENT_OPEN_ANGLE = 220; | // Open at 90
18 | const int VENT_CLOSE_ANGLE = 0; | // Closed at 0

19
20 // Timing variables

21 | unsigned long lastReceivedTime1 = 0;
22 | unsigned long lastReceivedTime2 = 0;

23
24 | // Default State of vents
25 | bool vent1Closed = false ;
26 | bool vent2Closed = false ;

27
28 | // Debug flag
29 | bool debugMode = true ;

30
31 | void setup () {
32 | Serial . begin (115200) ;
33 | delay (1000) ; // Give serial time to initialize

34
35 Serial . println ("=== ESP32 Servo Controller Starting === ") ;

36
37 | // Initialize UART2
38 | Serial2 . begin (9600 , SERIAL_8N1 , UART_RX , UART_TX ) ;
39 | Serial . println (" UART2 initialized on pins RX :16 , TX :17 ") ;

40
41 | // PWM channel setup with new API ( ESP32 Arduino Core v3.x)
42 | if (! ledcAttach ( VENT1_SERVO_PIN , pwmFreq , pwmResolution ) ) {
43 | Serial . println (" ERROR : Failed to setup PWM for Servo 1") ;
44 | } else {
45 | Serial . println (" PWM for Servo 1 setup successful ") ;
46 | }

47
48 | if (! ledcAttach ( VENT2_SERVO_PIN , pwmFreq , pwmResolution ) ) {
49 | Serial . println (" ERROR : Failed to setup PWM for Servo 2") ;
50 | } else {
51 | Serial . println (" PWM for Servo 2 setup successful ") ;
52 | }

53
54 | // Initialize vents as open with delay
55 | Serial . println (" Initializing servos to OPEN position ... ") ;
56 | moveServo ( VENT1_SERVO_PIN , VENT_OPEN_ANGLE ) ;
57 | delay (1000) ; // Give servo time to move
58 | moveServo ( VENT2_SERVO_PIN , VENT_OPEN_ANGLE ) ;
59 | delay (1000) ;

60
61 | // Initialize timing
62 | lastReceivedTime1 = millis () ;
63 | lastReceivedTime2 = millis () ;

64
65 | Serial . println ("=== Setup Complete - Waiting for UART2 data === ") ;
66 | Serial . println (" Expected format : ’Frame 1 ’ or ’Frame 2 ’") ;
67 | Serial . println (" Timeout : Frame 1 = 15s, Frame 2 = 15s") ;
68 | }

69
70 | void loop () {
71 | // Check for UART data
72 | if ( Serial2 . available () ) {
73 | String received = Serial2 . readStringUntil (’\n’) ;
74 | received . trim () ;

75
76 | if ( received . length () > 0) {
77 | if ( debugMode ) {
78 | Serial . print ("[ UART ] Received : ’") ;
79 | Serial . print ( received ) ;
80 | Serial . println ("’") ;

81 | }

82
83 | // Check for Frame 1
84 | if ( received . indexOf (" Frame 1") != -1) {
85 | lastReceivedTime1 = millis () ;
86 | Serial . println ("[ FRAME1 ] Signal detected - Opening vent 1") ;

87
88 | if ( vent1Closed ) {
89 | moveServo ( VENT1_SERVO_PIN , VENT_OPEN_ANGLE ) ;
90 | vent1Closed = false ;
91 | Serial . println ("[ FRAME1 ] Vent 1 opened ") ;
92 | } else {
93 | Serial . println ("[ FRAME1 ] Vent 1 already open ") ;
94 | }
95 | }
96 | // Check for Frame 2
97 | else if ( received . indexOf (" Frame 2") != -1) {
98 | lastReceivedTime2 = millis () ;
99 | Serial . println ("[ FRAME2 ] Signal detected - Opening vent 2") ;

100
101 | if ( vent2Closed ) {
102 | moveServo ( VENT2_SERVO_PIN , VENT_OPEN_ANGLE ) ;
103 | vent2Closed = false ;
104 | Serial . println ("[ FRAME2 ] Vent 2 opened ") ;
105 | } else {
106 | Serial . println ("[ FRAME2 ] Vent 2 already open ") ;
107 | }
108 | }
109 | else {
110 | Serial . print ("[ WARNING ] Unknown message : ") ;
111 | Serial . println ( received ) ;
112 | }
113 | }
114 | }

115
116 | // Timeout logic for Frame 1 (15 seconds ) Change 15000 to desired time
| in ms
117 | if (! vent1Closed && ( millis () - lastReceivedTime1 > 15000) ) {
118 | Serial . println ("[ TIMEOUT ] Frame 1 timeout - Closing vent 1") ;
119 | moveServo ( VENT1_SERVO_PIN , VENT_CLOSE_ANGLE ) ;
120 | vent1Closed = true ;
121 | }

122
123 | // Timeout logic for Frame 2 (15 seconds ) Change 15000 to desired time
| in ms
124 | if (! vent2Closed && ( millis () - lastReceivedTime2 > 15000) ) {
125 | Serial . println ("[ TIMEOUT ] Frame 2 timeout - Closing vent 2") ;
126 | moveServo ( VENT2_SERVO_PIN , VENT_CLOSE_ANGLE ) ;
127 | vent2Closed = true ;
128 | }

129
130 | // Debug status every 10 seconds
131 | static unsigned long lastDebugTime = 0;
132 | if ( debugMode && ( millis () - lastDebugTime > 10000) ) {
133 | printStatus () ;
134 | lastDebugTime = millis () ;
135 | }

136
137 | // Check for serial commands for testing
138 | if ( Serial . available () ) {

139 | String command = Serial . readStringUntil (’\n’) ;
140 | command . trim () ;
141 | command . toLowerCase () ;

142
143 | if ( command == " test1 ") {
144 | Serial . println ("[ TEST ] Testing Servo 1") ;
145 | moveServo ( VENT1_SERVO_PIN , VENT_CLOSE_ANGLE ) ;
146 | delay (1000) ;
147 | moveServo ( VENT1_SERVO_PIN , VENT_OPEN_ANGLE ) ;
148 | }
149 | else if ( command == " test2 ") {
150 | Serial . println ("[ TEST ] Testing Servo 2") ;
151 | moveServo ( VENT2_SERVO_PIN , VENT_CLOSE_ANGLE ) ;
152 | delay (1000) ;
153 | moveServo ( VENT2_SERVO_PIN , VENT_OPEN_ANGLE ) ;
154 | }
155 | else if ( command == " status ") {
156 | printStatus () ;
157 | }
158 | else if ( command == " debug ") {
159 | debugMode = ! debugMode ;
160 | Serial . print ("[ DEBUG ] Debug mode : ") ;
161 | Serial . println ( debugMode ? "ON" : "OFF ") ;
162 | }
163 | }

164
165 | delay (50) ; // Small delay to prevent excessive CPU usage
166 | }

167
168 | // Improved servo control function for MG996R
169 | void moveServo (int pin , int angle ) {
170 | // Constrain angle
171 | angle = constrain ( angle , 0 , 180) ;

172
173 | // Calculate duty cycle for MG996R (1ms -2 ms pulse width )
174 | // For 16 - bit resolution at 50 Hz:
175 | // 1ms = 3277 , 1.5 ms = 4915 , 2ms = 6553
176 | int minDuty = 3277; | // 1ms pulse width (0 degrees )
177 | int maxDuty = 6553; | // 2ms pulse width (180 degrees )

178
179 int duty = map ( angle , 0 , 180 , minDuty , maxDuty ) ;

180
181 ledcWrite ( pin , duty ) ;

182
183 | // Debug output
184 | Serial . print ("[ SERVO ] Pin ") ;
185 | Serial . print ( pin ) ;
186 | Serial . print (" set to ") ;
187 | Serial . print ( angle ) ;
188 | Serial . print (" | ( duty : ") ;
189 | Serial . print ( duty ) ;
190 | Serial . println (")") ;
191 | }

192
193 | // Status printing function
194 | void printStatus () {
195 | Serial . println ("=== STATUS === ") ;
196 | Serial . print (" Vent 1: ") ;
197 | Serial . print ( vent1Closed ? " CLOSED " : " OPEN ") ;
198 | Serial . print (" | Last signal : ") ;

199 | Serial . print (( millis () - lastReceivedTime1 ) / 1000) ;
200 | Serial . println ("s ago ") ;

201
202 | Serial . print (" Vent 2: ") ;
203 | Serial . print ( vent2Closed ? " CLOSED " : " OPEN ") ;
204 | Serial . print (" | Last signal : ") ;
205 | Serial . print (( millis () - lastReceivedTime2 ) / 1000) ;
206 | Serial . println ("s ago ") ;

207
208 | Serial . print (" Free heap : ") ;
209 | Serial . print ( ESP . getFreeHeap () ) ;
210 | Serial . println (" bytes ") ;
211 | Serial . println (" ============= ") ;
212 | }

Images of Working

The images show the POC running the code for Human detection and Vent Opening.

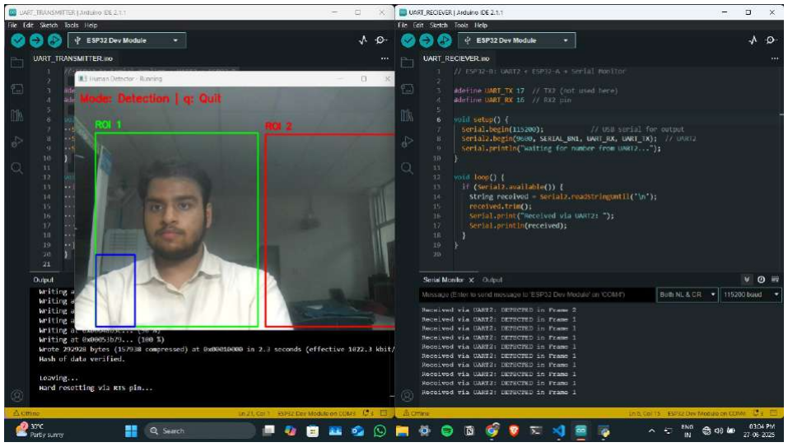
[picture p17: figure]

Figure 3.11: Detection in Frame 1

# Chapter 4

# Future Work

This project lays the foundation for several avenues of future improvements and enhancements. Key directions for advancement, categorized by relevant subsystems, are outlined below.

## 4.1 Electronics and Controllers

Future iterations of the system can benefit significantly from improved hardware and optimized software. For instance, a Raspberry Pi 5 can be employed as the camera controller to provide greater processing power, while upgrading to Camera Module 3 will enable higher resolution image capture. Additionally, migrating from UART to CAN bus communication would better emulate the architecture of real-world automotive systems, ensuring more robust and scalable communication.
On the software side, the current human detection method based on HOG can be upgraded to more accurate and efficient deep learning-based approaches such as the YOLO (You Only Look Once) object detection model. Furthermore, the system should eventually be transitioned to run on actual vehicle-grade embedded controllers to ensure real-world applicability.

## 4.2 Actuator Mechanism

The actuator mechanism controlling the AC vents can be significantly enhanced. A more robust and versatile design should be developed, capable of precise control in all required directions of motion. The mechanism must also be manufacturable at scale and designed for long-term reliability. Special focus should be placed on minimizing mechanical failure, simplifying assembly, and ensuring consistency across multiple units.

# Acknowledgment

I would like to express my sincere gratitude to all those who supported and guided me throughout the course of this Summer Internship.
First and foremost, I am deeply thankful to Kartar Sir, my project mentor, for his invaluable guidance, encouragement, and technical insights. His expertise and feedback were instrumental in shaping the direction of this work. Under his and his team’s mentorship, I was able to learn a great deal about the various vehicles being developed and the manufacturing processes involved.
I would also like to thank the Tata Motors Engineering Research Centre for providing the necessary infrastructure and resources to carry out the research and development of the system. The experience was immensely educational and enriching. I would also like to thank Girish Sir, Surabhi Ma’am, and Gurvinder Sir; without their guidance this project would not have been completed on time. I am equally grateful to the Human Resources Team for ensuring a smooth transition and for providing me with this opportunity.
A special thanks to my teammates and peers for their constructive discussions and collaboration throughout the project. Their support helped me overcome several challenges during development and testing.
Lastly, I am deeply grateful to my family and friends for their constant encouragement and moral support, which played a significant role in the successful completion of this project.

# References

[1] Noema Technologies: (https://www.youtube.com/watch?v=W7d7-X7EiyQ) Real Time Passenger Detection System in Commercial Vehicles
[2] US Patent: (https://patents.google.com/patent/US20190009640A1/en) Using IR Sensor to sweep a passenger vehicle to detect Passenger Temperature
[3] Chinese Patent: (https://patents.google.com/patent/WO2018096819A1/en) Multiple IR Sensors to Detect Passenger Presence and control A.C. Systems
[4] Arduino IDE: (https://www.arduino.cc/en/software/) Download link for the Coding platform of ESP-32s
[5] Raspberry Pi Zero Setup Guide: (https://www.instructables.com/The-Ultimate-Headless-RPi-Zero-Setup-for-Beginners/) Guide to install the appropriate OS on Raspberry Pi Zero and how to set it up.
[6] GitHub Link: (https://github.com/HARSH070105/tml_work) Repository Link for all the Code files and Documentation related to the project.
