HARSH070105/tml_work/Codes/Pi Zero 2 W/PI Zero OS/issue.txt

Raspberry Pi reference 2025-05-13
Generated using pi-gen, https://github.com/RPi-Distro/pi-gen, f548f25325e28bea61904f5038a9b9fd0c92b07b, stage2
